jacobosarmiento0505-sketch/Fot-metro-Port-til-Jacobo-Sarmiento/docs/datasheets/README.md

# Hojas de datos y referencias

Documentación de los módulos y componentes usados (enlaces a los fabricantes;
no se copian los PDF al repositorio por tamaño y derechos de autor).

| Componente / módulo | Uso en el proyecto | Hoja de datos / referencia |
|---|---|---|
| TCS34725 (breakout HW-393) | Sensor de color I2C, 3,3 V | <https://ams-osram.com/products/sensors/color-sensors/ams-tcs34725-color-sensor> |
| SSD1306 (OLED 128x64 I2C) | Pantalla | <https://cdn-shop.adafruit.com/datasheets/SSD1306.pdf> |
| TP4056 (módulo carga + boost 5 V) | Carga Li-Po y riel de 5 V | <https://dlnmh9ip6v2uc.cloudfront.net/datasheets/Prototyping/TP4056.pdf> |
| ESP32 (placa de desarrollo) | Microcontrolador, regulador interno a 3,3 V | <https://www.espressif.com/sites/default/files/documentation/esp32_datasheet_en.pdf> |
| Interruptor Würth WS-SLTV | Encendido (SPDT deslizante) | <https://www.we-online.com/en/components/products/WS-SLTV> |
| Footprints/símbolos KiCad | Bibliotecas oficiales | <https://www.kicad.org/libraries/> |

Las dimensiones y pines de los footprints se revisaron contra estas hojas de
datos y contra los módulos físicos (separación de pines 2,54 mm).
