jacobosarmiento0505-sketch/Fot-metro-Port-til-Jacobo-Sarmiento/electronica/kicad/drc_report.txt

** Drc report for electronica/kicad/fotometro.kicad_pcb **
** Created on 2026-10-30 11:48:46 **

** Found 1 DRC violations **
[copper_sliver]: Copper sliver (B.Cu)
    Local override; Severity: warning

** Found 0 unconnected pads **

** Found 0 Footprint errors **

** End of Report **
