jacobosarmiento0505-sketch/Fot-metro-Port-til-Jacobo-Sarmiento/software/README.md

# Software de apoyo

Carpeta reservada para scripts de análisis de datos (p. ej. curvas de
calibración, procesamiento de mediciones exportadas desde el equipo) u
otras herramientas de software que acompañen al proyecto.

Pendiente de implementación.
