jacobosarmiento0505-sketch/Fot-metro-Port-til-Jacobo-Sarmiento/electronica/outputs/fotometro.step

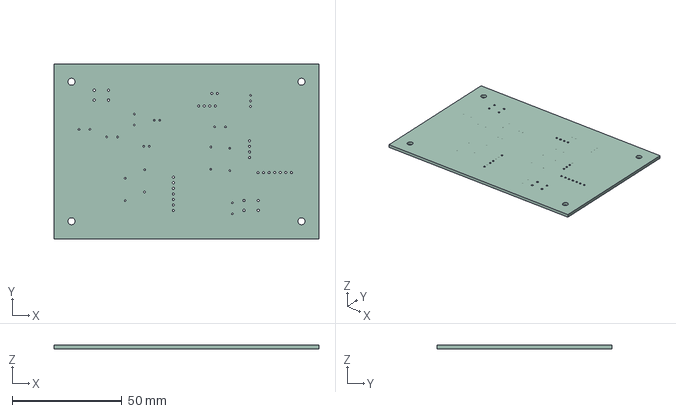
[picture p9: CAD file, 2026-10-30]
electronica/outputs/fotometro.step
120.8 x 79.6 x 1.60 mm
