jacobosarmiento0505-sketch/Fot-metro-Port-til-Jacobo-Sarmiento/electronica/outputs/fotometro_pcb.pdf

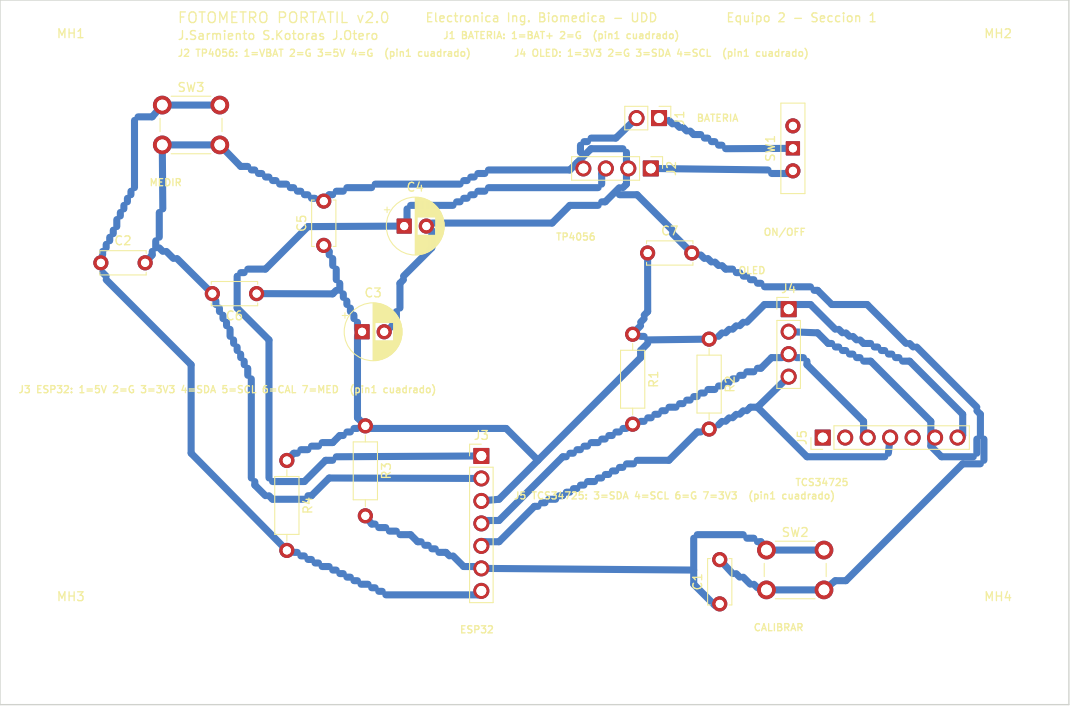
[picture p10: page 1]
