jacobosarmiento0505-sketch/Fot-metro-Port-til-Jacobo-Sarmiento/electronica/kicad/fotometro.kicad_pcb

## KiCad design electronica/kicad/fotometro.kicad_pcb (2026-10-30)

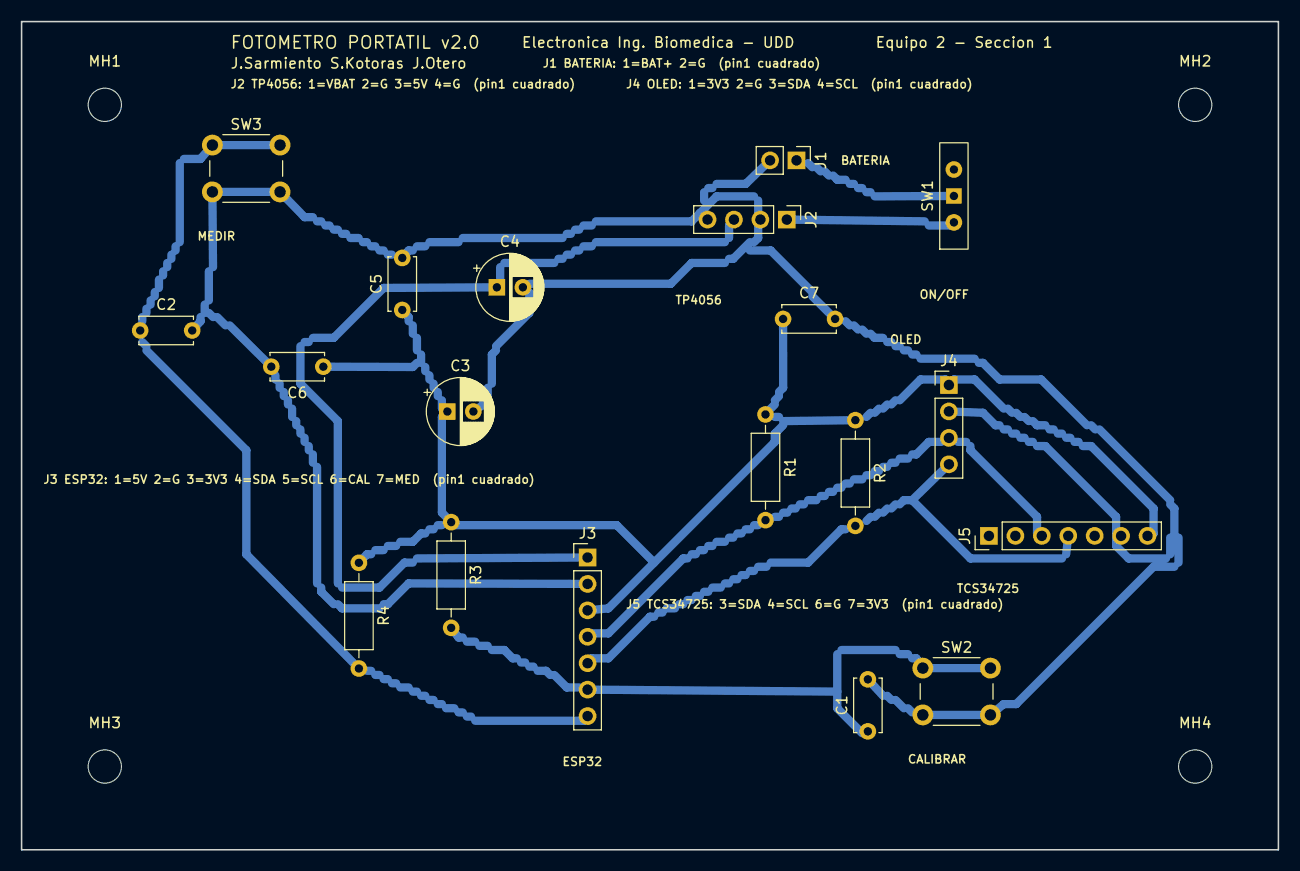
[picture p11: board fotometro.kicad_pcb from above]

Board: 2 copper layers, 120.8 x 79.6 mm, 23 parts (0 on the bottom side), 9 nets.

Parts:
C1, C2, C5, C6, C7: 100nF; C_Disc_D5.0mm_W2.5mm_P5.00mm
C3, C4: 100uF; CP_Radial_D6.3mm_P2.50mm
J1: Bateria Li-Po; PinHeader_1x02_P2.54mm_Vertical
J2: TP4056+Boost5V; PinHeader_1x04_P2.54mm_Vertical
J3: ESP32; PinHeader_1x07_P2.54mm_Vertical
J4: OLED SSD1306; PinHeader_1x04_P2.54mm_Vertical
J5: TCS34725; PinHeader_1x07_P2.54mm_Vertical
MH1, MH2, MH3, MH4: MountingHole_3.2mm_M3
R1, R2: 4.7k; R_Axial_DIN0207_L6.3mm_D2.5mm_P10.16mm_Horizontal
R3, R4: 10k; R_Axial_DIN0207_L6.3mm_D2.5mm_P10.16mm_Horizontal
SW1: Interruptor encendido; SW_Slide-03_Wuerth-WS-SLTV_10x2.5x6.4_P2.54mm
SW2: CALIBRAR; SW_PUSH_6mm
SW3: MEDIR; SW_PUSH_6mm

Connections:
BAT_RAW: J1.1, SW1.1
GND: C1.2, C2.2, C3.2, C4.2, C5.2, C6.2, C7.2, J1.2, J2.2, J2.4, J3.2, J4.2, J5.6, SW2.2, SW3.2
GPIO_CAL: C1.1, J3.6, R3.2, SW2.1
GPIO_MED: C2.1, J3.7, R4.2, SW3.1
SCL: J3.5, J4.4, J5.4, R2.2
SDA: J3.4, J4.3, J5.3, R1.2
VBAT_SW: J2.1, SW1.2
VCC_3V3: C3.1, C5.1, C6.1, C7.1, J3.3, J4.1, J5.7, R1.1, R2.1, R3.1, R4.1
VCC_5V: C4.1, J2.3, J3.1
